megasaturnv/arduino-voltmeter-clock/README.md

# arduino-voltmeter-clock
An Arduino-based clock which displays the date and time with voltmeters
