megasaturnv/arduino-voltmeter-clock/Voltmeter scale scans/scan1.jpg

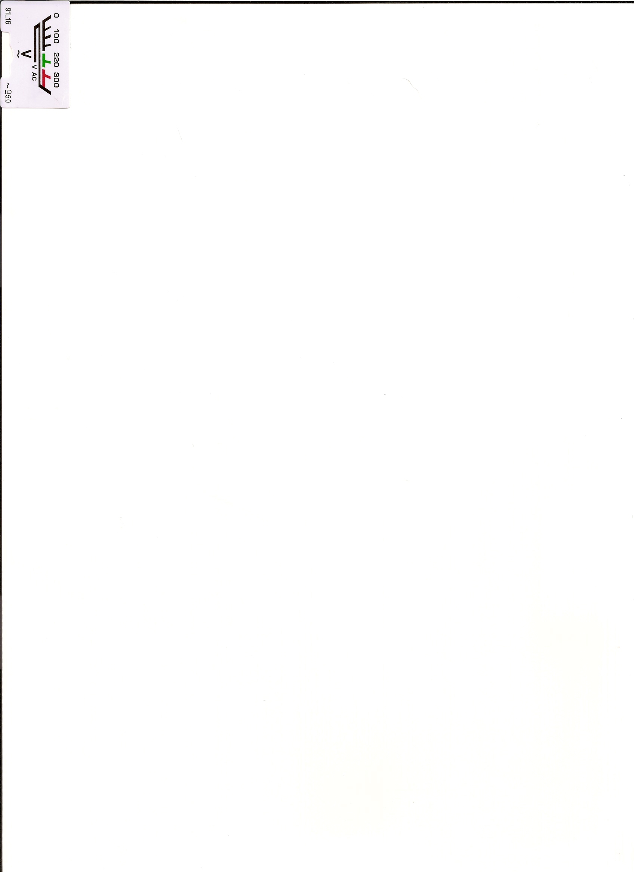
Voltmeter scale scans/scan1.jpg
