megasaturnv/arduino-voltmeter-clock/Voltmeter scale scans/scan2.jpg

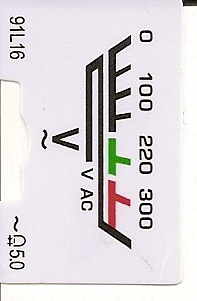
Voltmeter scale scans/scan2.jpg
