megasaturnv/arduino-voltmeter-clock/Voltmeter scale scans/scan3.jpg

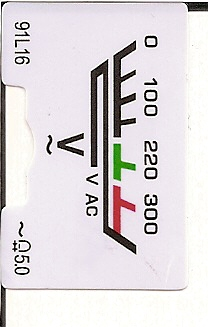
Voltmeter scale scans/scan3.jpg
