megasaturnv/arduino-voltmeter-clock/Voltmeter scale scans/scan4.jpg

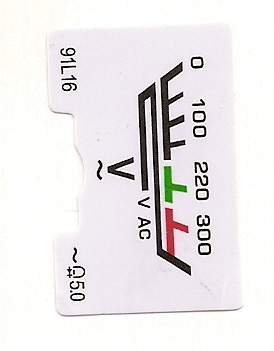
Voltmeter scale scans/scan4.jpg
