megasaturnv/arduino-voltmeter-clock/Voltmeter time displays/12months.png

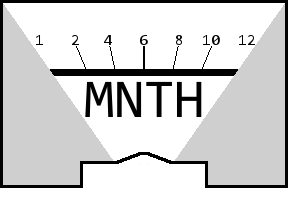
Voltmeter time displays/12months.png
