megasaturnv/arduino-voltmeter-clock/Voltmeter time displays/24hours.png

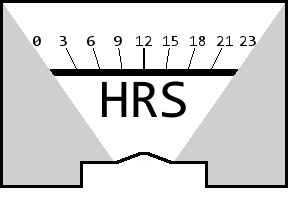
Voltmeter time displays/24hours.png
