megasaturnv/arduino-voltmeter-clock/Voltmeter time displays/31days.png

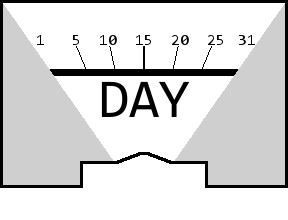
Voltmeter time displays/31days.png
