megasaturnv/arduino-voltmeter-clock/Voltmeter time displays/60minutes.png

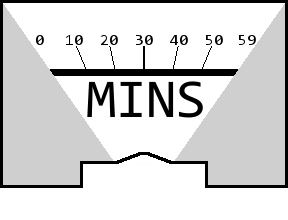
Voltmeter time displays/60minutes.png
