megasaturnv/arduino-voltmeter-clock/Voltmeter time displays/60seconds.png

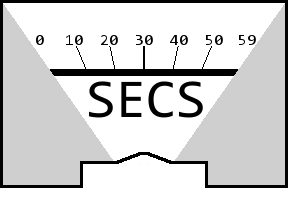
Voltmeter time displays/60seconds.png
