megasaturnv/arduino-voltmeter-clock/Kicad circuit board designs/voltmeterClockKiCad_rev2/voltmeterClockKiCad.kicad_pcb

## KiCad design Kicad circuit board designs/voltmeterClockKiCad_rev2/voltmeterClockKiCad.kicad_pcb (2018-02-14, an earlier design)

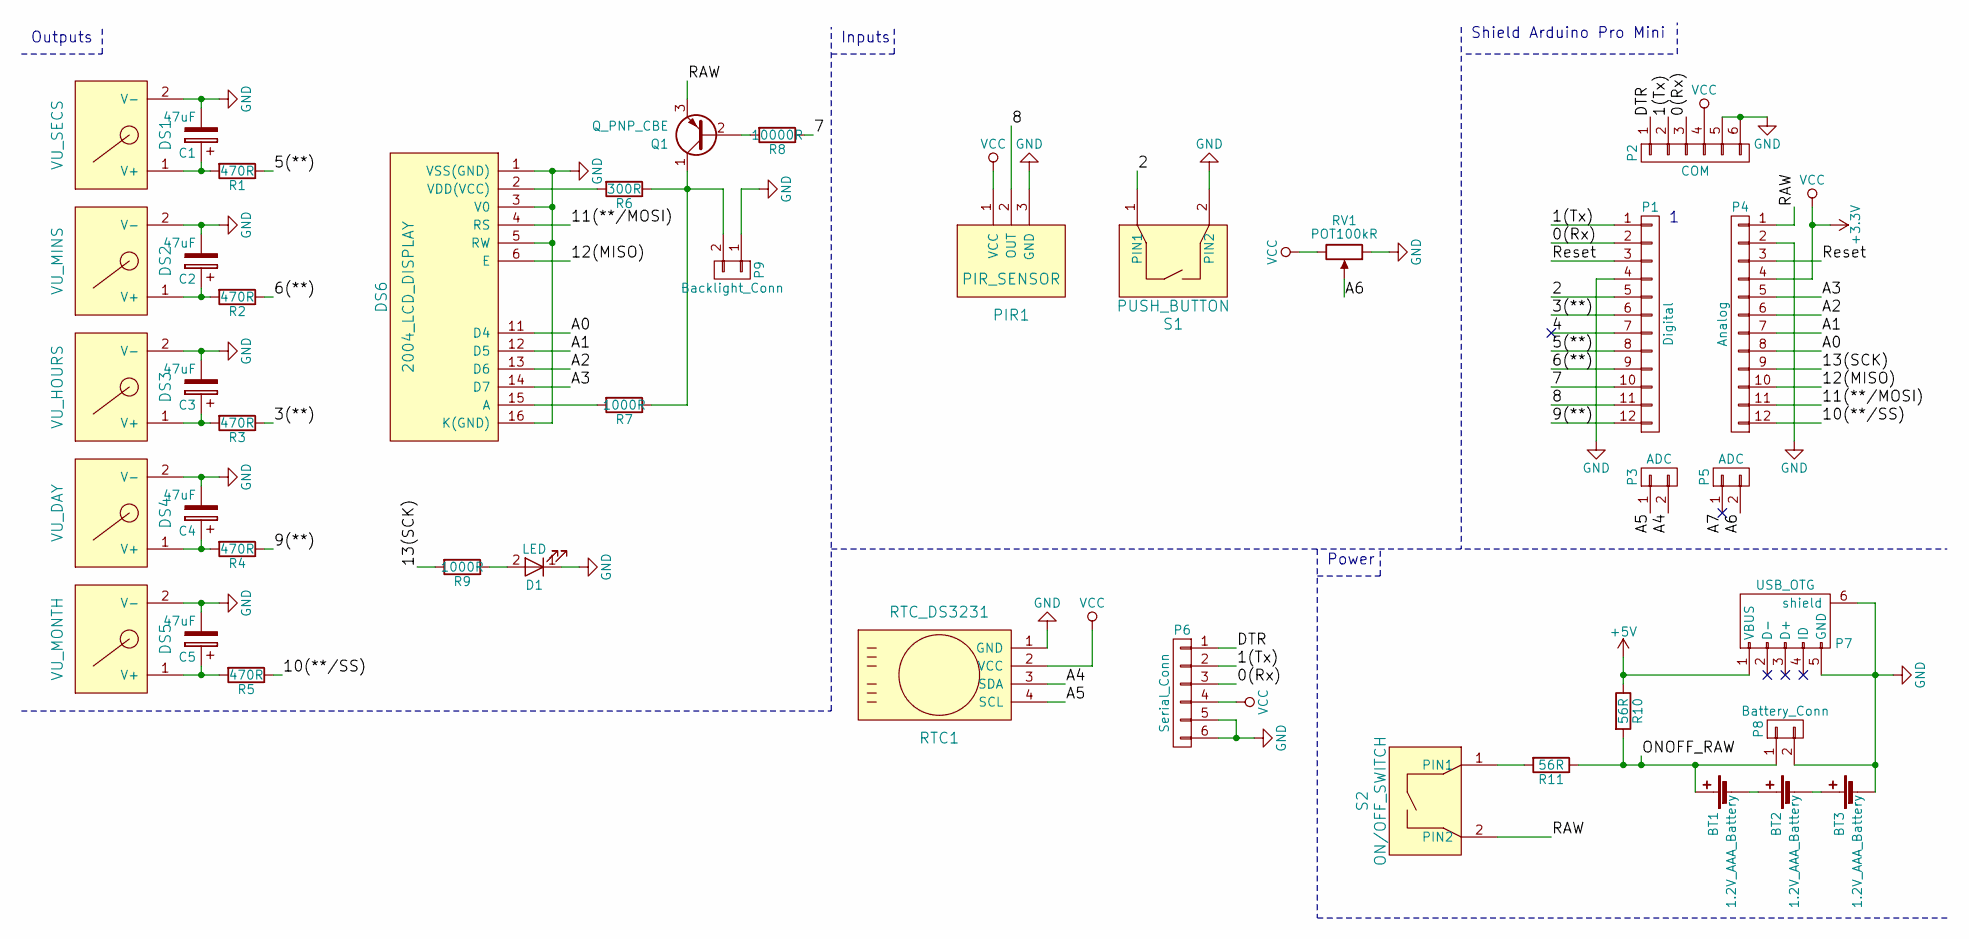
[picture p10: schematic voltmeterClockKiCad.sch, Voltmeter Clock]

Parts:
BT1, BT2, BT3: 1.2V_AAA_Battery
C1, C2, C3, C4, C5: 47uF; CP_Radial_D10.0mm_P5.00mm
D1: LED; Pin_Header_Straight_1x02_Pitch2.54mm
DS1: VU_SECS; Pin_Header_Straight_1x02_Pitch2.54mm
DS2: VU_MINS; Pin_Header_Straight_1x02_Pitch2.54mm
DS3: VU_HOURS; Pin_Header_Straight_1x02_Pitch2.54mm
DS4: VU_DAY; Pin_Header_Straight_1x02_Pitch2.54mm
DS5: VU_MONTH; Pin_Header_Straight_1x02_Pitch2.54mm
DS6: 2004_LCD_DISPLAY; Pin_Header_Straight_1x12_Pitch2.54mm
P1: Digital; Socket_Strip_Straight_1x12_Pitch2.54mm
P2: COM; Pin_Header_Straight_1x06_Pitch2.54mm
P3, P5: ADC; Pin_Header_Straight_1x02_Pitch2.54mm
P4: Analog; Socket_Strip_Straight_1x12_Pitch2.54mm
P6: Serial_Conn; Socket_Strip_Angled_1x06_Pitch2.54mm
P7: USB_OTG; USB_Micro-B
P8: Battery_Conn; Pin_Header_Straight_1x02_Pitch2.54mm
P9: Backlight_Conn; Pin_Header_Straight_1x02_Pitch2.54mm
PIR1: PIR_SENSOR; Pin_Header_Straight_1x03_Pitch2.54mm
Q1: Q_PNP_CBE; TO-92_Inline_Wide
R1, R2, R3, R4, R5: 470R; R_Axial_DIN0207_L6.3mm_D2.5mm_P10.16mm_Horizontal
R6: 300R; R_Axial_DIN0207_L6.3mm_D2.5mm_P10.16mm_Horizontal
R7, R9: 1000R; R_Axial_DIN0207_L6.3mm_D2.5mm_P10.16mm_Horizontal
R8: 10000R; R_Axial_DIN0207_L6.3mm_D2.5mm_P10.16mm_Horizontal
R10, R11: 56R; R_Axial_DIN0207_L6.3mm_D2.5mm_P10.16mm_Horizontal
RTC1: RTC_DS3231
RV1: POT100kR; Pin_Header_Straight_1x03_Pitch2.54mm
S1: PUSH_BUTTON; Pin_Header_Straight_1x02_Pitch2.54mm
S2: ON/OFF_SWITCH; Pin_Header_Straight_1x02_Pitch2.54mm

Connections:
+3V3: P2.4, P4.4, P6.4, PIR1.1 (VCC), RTC1.2 (VCC), RV1.3
+5V: P7.1 (VBUS), R10.1
/0(Rx): P1.2, P2.3, P6.3
/1(Tx): P1.1, P2.2, P6.2
/2: P1.5, S1.1 (PIN1)
/3(**): P1.6, R3.1
/4: P1.7
/5(**): P1.8, R1.1
/6(**): P1.9, R2.1
/7: P1.10, R8.1
/8: P1.11, PIR1.2 (OUT)
/9(**): P1.12, R4.1
/10(**/SS): P4.12, R5.1
/11(**/MOSI): DS6.4 (RS), P4.11
/12(MISO): DS6.6 (E), P4.10
/13(SCK): P4.9, R9.2
/A0: DS6.11 (D4), P4.8
/A1: DS6.12 (D5), P4.7
/A2: DS6.13 (D6), P4.6
/A3: DS6.14 (D7), P4.5
/A4: P3.2, RTC1.3 (SDA)
/A5: P3.1, RTC1.4 (SCL)
/A6: P5.2, RV1.2
/A7: P5.1
/DTR: P2.1, P6.1
/ONOFF_RAW: BT1.1 (+), P8.1, R10.2, R11.1
/RAW: P4.1, Q1.3 (E), S2.2 (PIN2)
/Reset: P1.3, P4.3
GND: BT3.2 (-), C1.2, C2.2, C3.2, C4.2, C5.2, D1.1 (K), DS1.2 (V-), DS2.2 (V-), DS3.2 (V-), DS4.2 (V-), DS5.2 (V-), DS6.1 (VSS(GND)), DS6.3 (V0), DS6.5 (RW), DS6.16 (K(GND)), P1.4, P2.5, P2.6, P4.2, P6.5, P6.6, P7.5 (GND), P7.6 (shield), P8.2, P9.1, PIR1.3 (GND), RTC1.1 (GND), RV1.1, S1.2 (PIN2)
unnamed: BT1.2 (-), BT2.1 (+)
unnamed: BT2.2 (-), BT3.1 (+)
unnamed: C1.1, DS1.1 (V+), R1.2
unnamed: C2.1, DS2.1 (V+), R2.2
unnamed: C3.1, DS3.1 (V+), R3.2
unnamed: C4.1, DS4.1 (V+), R4.2
unnamed: C5.1, DS5.1 (V+), R5.2
unnamed: D1.2 (A), R9.1
unnamed: DS6.2 (VDD(VCC)), R6.2
unnamed: DS6.15 (A), R7.2
unnamed: P9.2, Q1.1 (C), R6.1, R7.1
unnamed: Q1.2 (B), R8.2
unnamed: R11.2, S2.1 (PIN1)

Notes on the sheet:
Shield Arduino Pro Mini
Inputs
Outputs
Power

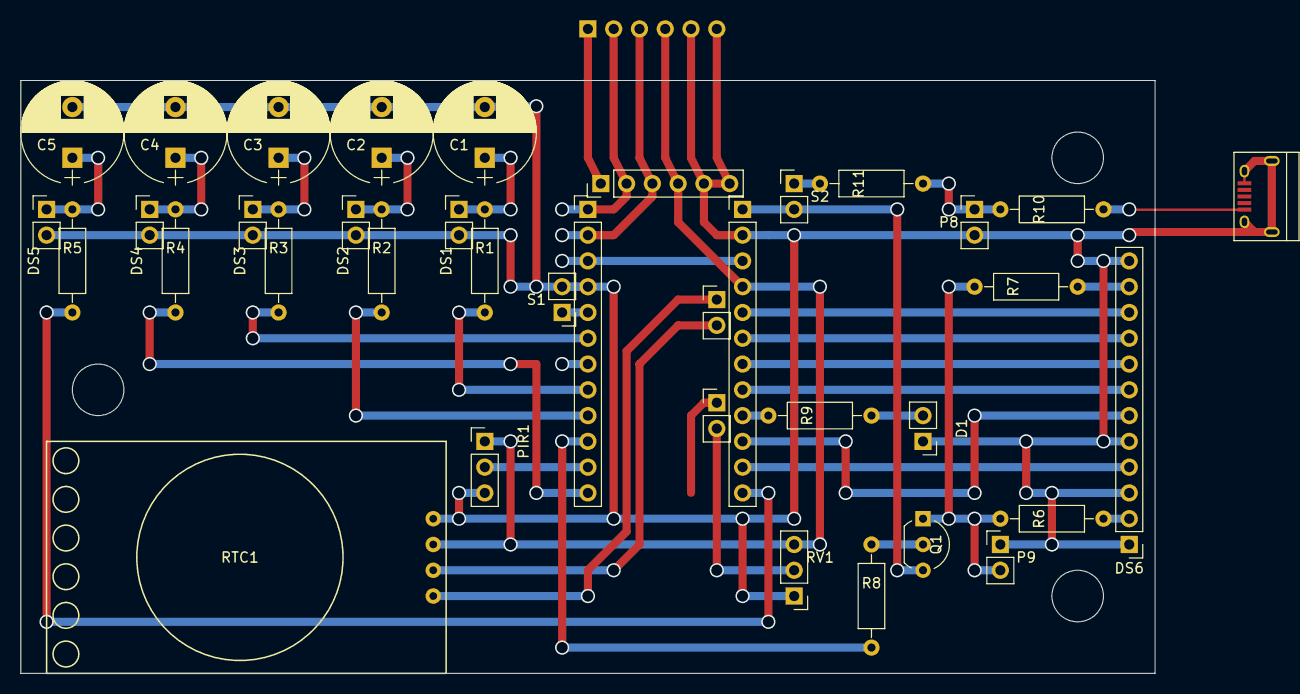
[picture p11: board voltmeterClockKiCad.kicad_pcb from above]

Board: 2 copper layers, 111.8 x 58.4 mm, 38 parts (1 on the bottom side), 38 nets.
