megasaturnv/arduino-voltmeter-clock/Kicad circuit board designs/voltmeterClockKiCad_rev1_daughter_board/voltmeterClockKiCadDaughterBoard.kicad_pcb

## KiCad design Kicad circuit board designs/voltmeterClockKiCad_rev1_daughter_board/voltmeterClockKiCadDaughterBoard.kicad_pcb (2018-02-14)

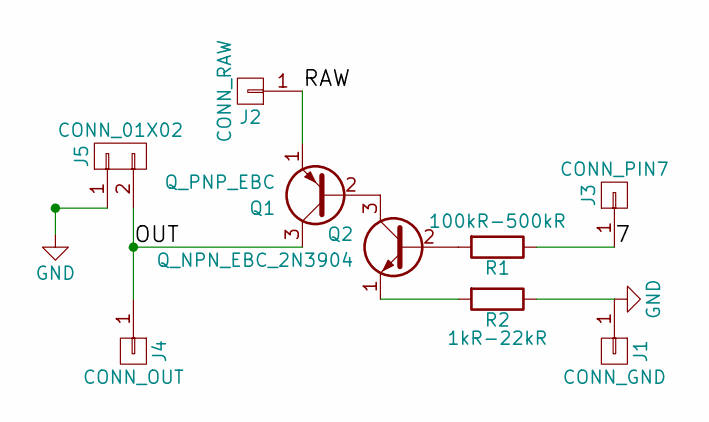
[picture p12: schematic voltmeterClockKiCadDaughterBoard.sch, Voltmeter clock daughter board]

Parts:
J1: CONN_GND; Pin_Header_Straight_1x01_Pitch2.54mm
J2: CONN_RAW; Pin_Header_Straight_1x01_Pitch2.54mm
J3: CONN_PIN7; Pin_Header_Straight_1x01_Pitch2.54mm
J4: CONN_OUT; Pin_Header_Straight_1x01_Pitch2.54mm
J5: CONN_01X02; Pin_Header_Straight_1x02_Pitch2.54mm
Q1: Q_PNP_EBC; TO-92_Inline_Wide
Q2: Q_NPN_EBC_2N3904; TO-92_Inline_Wide
R1: 100kR-500kR; R_Axial_DIN0207_L6.3mm_D2.5mm_P10.16mm_Horizontal
R2: 1kR-22kR; R_Axial_DIN0207_L6.3mm_D2.5mm_P10.16mm_Horizontal

Connections:
/7: J3.1, R1.1
/OUT: J4.1, J5.2, Q1.3 (C)
/RAW: J2.1, Q1.1 (E)
GND: J1.1, J5.1, R2.1
unnamed: Q1.2 (B), Q2.3 (C)
unnamed: Q2.1 (E), R2.2
unnamed: Q2.2 (B), R1.2

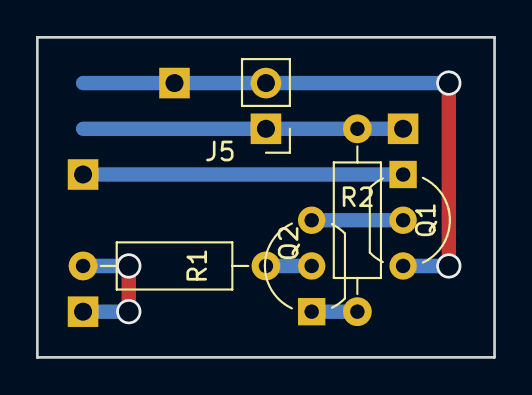
[picture p13: board voltmeterClockKiCadDaughterBoard.kicad_pcb from above]

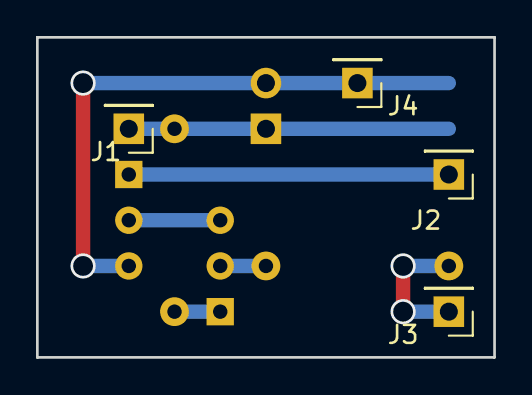
[picture p14: board voltmeterClockKiCadDaughterBoard.kicad_pcb from below]

Board: 2 copper layers, 25.4 x 17.8 mm, 9 parts (4 on the bottom side), 7 nets.
