megasaturnv/arduino-voltmeter-clock/Calibration data.ods

Months |  | Days |  | Hours |  | Minutes |  | Seconds
Value | PWMValue | Value | PWMValue | Value | PWMValue | Value | PWMValue | Value | PWMValue
1 | 0 | 1 | 10 | 0 | 3 | 0 | 21 | 0 | 9
2 | 23 | 5 | 38 | 3 | 18 | 10 | 48 | 10 | 42
4 | 52 | 10 | 61 | 6 | 37 | 20 | 69 | 20 | 68
6 | 82 | 15 | 87 | 9 | 52 | 30 | 94 | 30 | 97
8 | 127 | 20 | 120 | 12 | 69 | 40 | 132 | 40 | 136
10 | 188 | 25 | 164 | 15 | 87 | 50 | 176 | 50 | 185
12 | 255 | 31 | 232 | 18 | 111 | 59 | 250 | 59 | 255
 |  |  |  | 21 | 141
 |  |  |  | 23 | 183
