megasaturnv/arduino-voltmeter-clock/(commit log)

2018-02-14 Initial upload
    [Calibration data.ods, Pins layout.ods]
2018-02-14 Added PIR sensor
